JustavGunker/AMR-Project/34720 Fagprojekt Space1/stm32g431.jpg

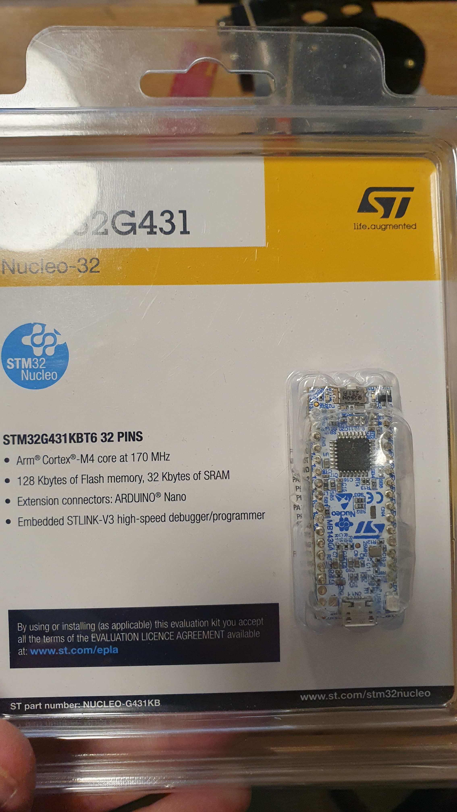
34720 Fagprojekt Space1/stm32g431.jpg
