JustavGunker/AMR-Project/34720 Fagprojekt Space1/block_diagram_inital.jpeg

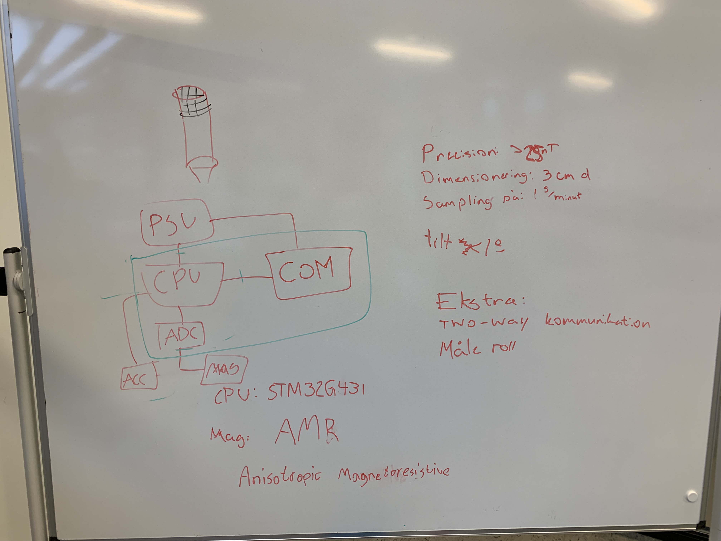
34720 Fagprojekt Space1/block_diagram_inital.jpeg
