JustavGunker/AMR-Project/README.md

# AMR-Project
Introductory Project in Electrotechnology 2024. AMR sensor system built with STM32G431
