JustavGunker/AMR-Project/34720 Fagprojekt Space1/block_diagram_final.jpg

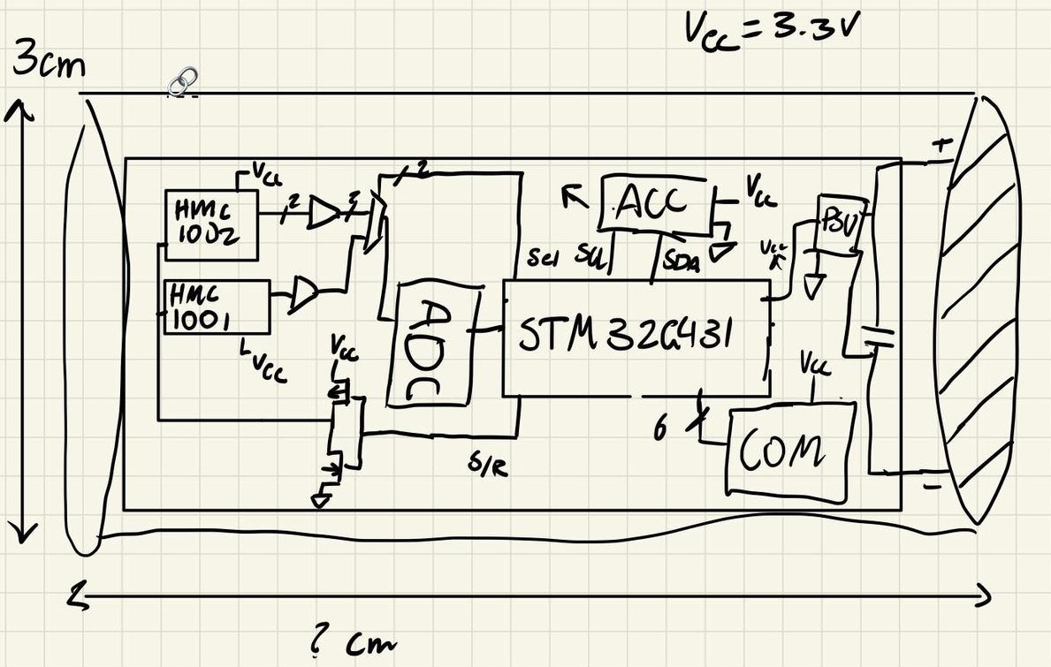
34720 Fagprojekt Space1/block_diagram_final.jpg
