JustavGunker/AMR-Project/34720 Fagprojekt Space1/schematic_amr.png

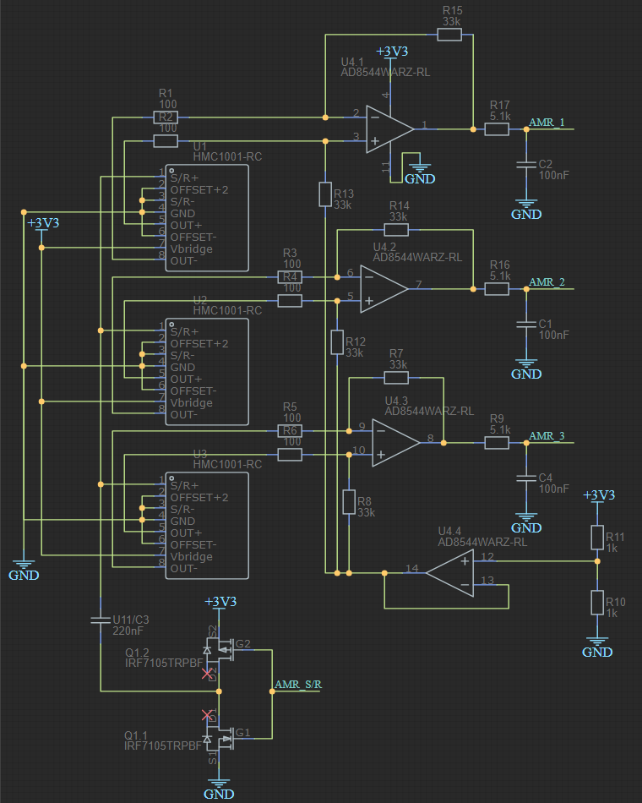
34720 Fagprojekt Space1/schematic_amr.png
