JustavGunker/AMR-Project/34720 Fagprojekt Space1/schematic_digital.png

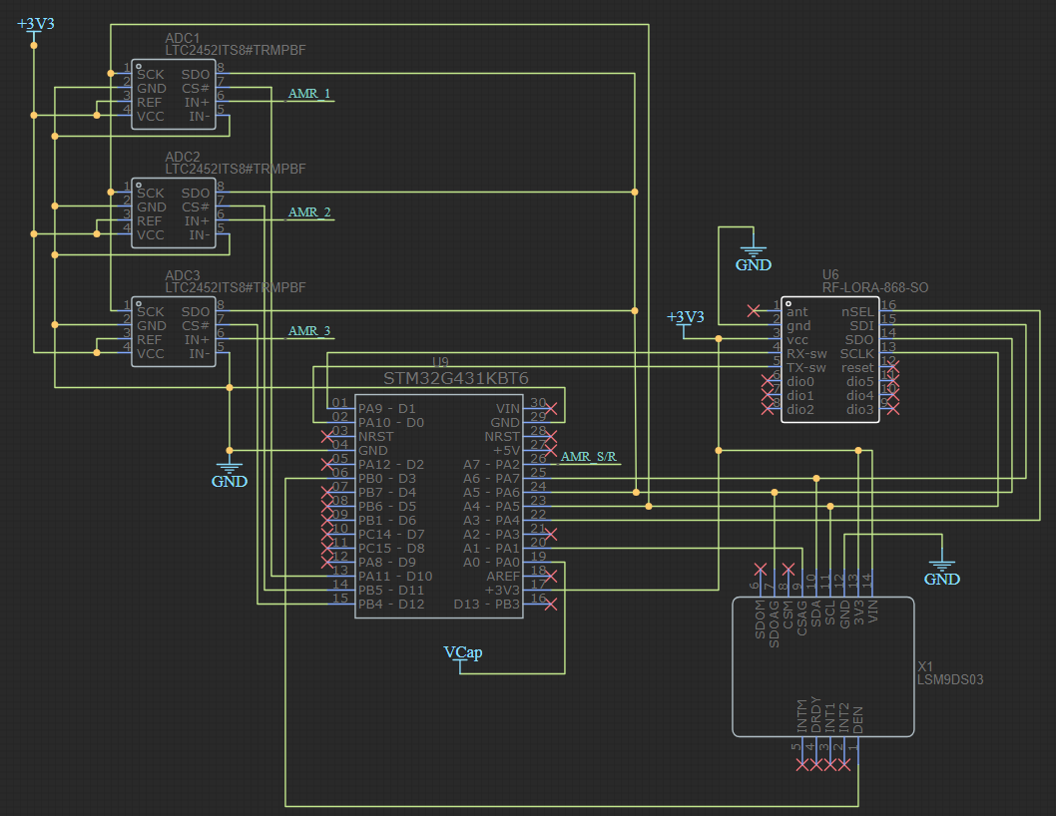
34720 Fagprojekt Space1/schematic_digital.png
