JustavGunker/AMR-Project/34720 Fagprojekt Space1/schematic_psu.png

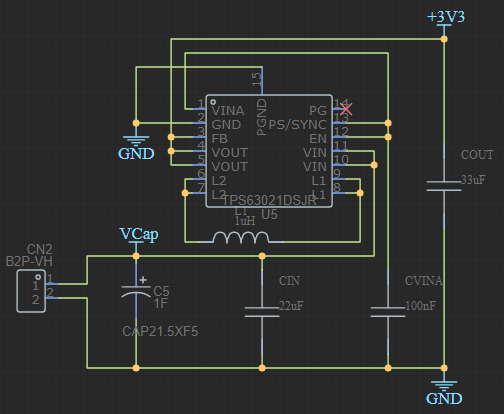
34720 Fagprojekt Space1/schematic_psu.png
