JustavGunker/AMR-Project/Receiver_CPU/receiver/Core/Src/main.c

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
/* Includes ------------------------------------------------------------------*/
#include "main.h"

/* USER CODE BEGIN Includes */
#include <stdio.h>
#include "tilt.h"
#include "adc.h"
#include "lora.h"


#include "string.h"
#include "stdio.h"
#include "lora.h"


/* USER CODE END Includes */

/* USER CODE BEGIN PTD */
adc_t adc1;
adc_t adc2;
adc_t adc3;
/* USER CODE END PTD */

SPI_HandleTypeDef hspi1;

/* USER CODE BEGIN PV */

<<<<<<<< HEAD:AMR_receiver/receiver/Core/Src/main.c
uint8_t hello[15] = "Hello, World!\n\r";
uint8_t new_line[1] = "\n";


char uart_buf[50];
uint8_t uart_buf_len;
int ESC = 0x1B;
uint8_t rx_buffer[256];

========
>>>>>>>> f46711b7818af0db365b4cb3413287fc9408f5cf:AMR-CPU/Core/Src/main.c

/* USER CODE END PV */

void SystemClock_Config(void);
static void MX_GPIO_Init(void);
static void MX_SPI1_Init(void);
/* USER CODE BEGIN PFP */
float read_battery(ADC_HandleTypeDef *hadc);
void transmit_data(SPI_HandleTypeDef* spi, char* data);
void get_measurements(SPI_HandleTypeDef* spi, adc_t adcx, adc_t adcy, adc_t adcz, char* data);
/* USER CODE END PFP */

/* USER CODE BEGIN 0 */

void clrscr();
void gotoxy(uint8_t x, uint8_t y);
void uart_read(void);
void enter_lpr_mode();
void exit_lpr_mode();

/* USER CODE END 0 */

/**
  * @brief  The application entry point.
  * @retval int
  */
int main(void)
{

  /* MCU Configuration--------------------------------------------------------*/

  /* Reset of all peripherals, Initializes the Flash interface and the Systick. */
  HAL_Init();

  /* Configure the system clock */
  SystemClock_Config();

  /* Initialize all configured peripherals */
  MX_GPIO_Init();
  MX_SPI1_Init();
  /* USER CODE BEGIN 2 */
<<<<<<<< HEAD:AMR_receiver/receiver/Core/Src/main.c
  char send_data[200];
  uint8_t rx, rx1, rx2, rx_flag, reg_value, send_it, cnt = 0;
  uint8_t tx, tx1 = 0;
  uint8_t addr, addr2, addr3 = 0;
  uint8_t mode;

  char data_read[100];

  uint8_t uart_buf_len = 0;

  HAL_GPIO_WritePin(GPIOA, RST_LoRa_Pin, GPIO_PIN_RESET);
  LoRa_reset();


  clrscr();
  gotoxy(0,0);

  LoRa_init(&hspi1);

  HAL_GPIO_WritePin(GPIOA, TX_Pin, GPIO_PIN_RESET);
  HAL_GPIO_WritePin(GPIOA, RX_Pin, GPIO_PIN_SET);

  LoRa_write_reg(&hspi1, RegFiFoTxBaseAddr, 0x00);
  HAL_Delay(10);

  //LoRa_fill_fifo(&hspi1, text, strlen(text));

  LoRa_set_mode(&hspi1, rx_cont_mode);
  mode = 1;
========
  HAL_PWREx_EnableLowPowerRunMode(); // enable low power run
  LSM9DS1_Init(&hspi1);
  ADC_Init(&adc1,&adc2,&adc3);
  //LoRa_reset();
  LoRa_init(&hspi1);

  HAL_GPIO_WritePin(GPIOA, TX_Pin, GPIO_PIN_SET);  // Enable TX path
  HAL_GPIO_WritePin(GPIOA, RX_Pin,GPIO_PIN_RESET); // Disable RX path

  char tx_data[100];
  float battery;
  uint8_t low_battery = 0;
  uint8_t first = 1; // To check for first measurement to bypass delay in first while loop

  // Initialize delay
  uint32_t tickstart = HAL_GetTick();
  uint32_t wait = 1500; // Time to wait between each measurement + transmission
  /* Add a freq to guarantee minimum wait */
  if (wait < HAL_MAX_DELAY){
  	  wait += (uint32_t)(uwTickFreq);
  	  }

>>>>>>>> f46711b7818af0db365b4cb3413287fc9408f5cf:AMR-CPU/Core/Src/main.c

  /* USER CODE END 2 */

  /* Infinite loop */
  /* USER CODE BEGIN WHILE */

  while (1)
  {
	  battery = read_battery(&hadc1);

	  if(battery < 1.0 && low_battery){
		  break;
	  }	else if(battery < 1.0){
		  low_battery = 1;
		  strcpy(tx_data, "");
		  sprintf(tx_data,"Battery low");
		  transmit_data(&hspi1, tx_data);
		  break;
	  } else if(!((HAL_GetTick() - tickstart) < wait) || first){
		  if(first){
			  first = 0;
			  HAL_Delay(1000);
		  }

		  low_battery = 0;
		  // Set reset of AMR-sensors
		  HAL_GPIO_WritePin(GPIOA, AMR_RESET_Pin,GPIO_PIN_SET);
		  HAL_GPIO_WritePin(GPIOA, AMR_RESET_Pin,GPIO_PIN_RESET);

		  // Sensor measurements, calculations and transmission of data
		  get_measurements(&hspi1,adc3,adc2,adc1,tx_data);
		  transmit_data(&hspi1, tx_data);

		  // Restart delay
		  tickstart = HAL_GetTick();
		  wait = 1500;
		  if (wait < HAL_MAX_DELAY){
			  wait += (uint32_t)(uwTickFreq);
			  }
	  }

    /* USER CODE END WHILE */

    /* USER CODE BEGIN 3 */
	  gotoxy(0,0);

	  /*
	  //LoRa receive and print and send for 2-way com
	  if (mode != 1) {
		  toggle_pins(&hspi1);
		  LoRa_set_mode(&hspi1, rx_cont_mode);
		  mode = 1;
		  rx = 0;
		  clrscr();
	  }

	  rx = (LoRa_read_reg(&hspi1, RegIrqFlags) & 0x40) >> 6;

	  LoRa_read_payload(&hspi1, data_read);

	  rx1 = LoRa_read_reg(&hspi1, RegRxNbBytes);
	  rx2 = LoRa_read_reg(&hspi1, RegOpMode);

	  uart_buf_len = sprintf(send_data, "Waiting, RegOpMode: %d, mode: %d\n\r", rx2, mode);
	  HAL_UART_Transmit(&huart2, (uint8_t*)send_data, uart_buf_len, 500);

	  if (rx) {
		  uart_buf_len = sprintf(send_data, "Payload: %s, rx_done: %d, bytes: %d", data_read,  rx, rx1);
		  HAL_UART_Transmit(&huart2, (uint8_t*)send_data, uart_buf_len, 500);
		  HAL_Delay(5000);
		  clrscr();

		  for (int i = 0; i <= 2; i++) {
			  LoRa_fill_fifo(&hspi1, text, strlen(text));
			  toggle_pins(&hspi1);
			  LoRa_set_mode(&hspi1, tx_mode);
			  mode = 0;
			  reg_value = LoRa_read_reg(&hspi1, RegOpMode);
			  tx = (LoRa_read_reg(&hspi1, RegIrqFlags) & 0x08) >> 3;
			  if (tx) {
				  send_it = 1;
				  LoRa_write_reg(&hspi1, RegIrqFlags, 0x08);
				  tx = 0;
				  sprintf(send_data, "send it: %d, mode: %d", send_it, reg_value);
				  HAL_UART_Transmit(&huart2, (uint8_t*)send_data, strlen(send_data), 500);
				  send_it = 0;
			  }

			  HAL_Delay(1000);
		  }
		  LoRa_set_mode(&hspi1, sleep_mode);
		  mode = 0;
		  HAL_Delay(10);
	  }*/


	  //LoRa receive and print
	  rx = (LoRa_read_reg(&hspi1, RegIrqFlags) & 0x40) >> 6;

	  rx1 = LoRa_read_reg(&hspi1, RegRxNbBytes);
	  rx2 = LoRa_read_reg(&hspi1, RegOpMode);

	  uart_buf_len = sprintf(send_data, "Waiting, RegOpMode: %d\n\r", rx2);
	  HAL_UART_Transmit(&huart2, (uint8_t*)send_data, uart_buf_len, 500);

	  if (rx) {
		  LoRa_read_payload(&hspi1, data_read);
		  clrscr();
		  uart_buf_len = sprintf(send_data, "Payload:\n\r%s\n\rbytes: %d", data_read, rx1);
		  HAL_UART_Transmit(&huart2, (uint8_t*)send_data, uart_buf_len, 500);
		  LoRa_set_mode(&hspi1, sleep_mode);
		  HAL_Delay(10);
		  LoRa_set_mode(&hspi1, rx_cont_mode);
	  }



  }
  /* USER CODE END 3 */
}

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
/* USER CODE BEGIN 4 */
float read_battery(ADC_HandleTypeDef *hadc){
	uint16_t adc_read;
	HAL_ADC_Start(hadc);
	HAL_ADC_PollForConversion(hadc,HAL_MAX_DELAY);
	adc_read = HAL_ADC_GetValue(hadc);

	return (float)(adc_read*3.3)/4096;
}

void transmit_data(SPI_HandleTypeDef* spi, char* data){
	  uint8_t addr = RegIrqFlags;
	  LoRa_set_mode(spi,stdby_mode);
	  HAL_Delay(10);

	  LoRa_fill_fifo(spi, data, strlen(data));
	  LoRa_set_mode(spi, tx_mode);
	  HAL_Delay(10);
	  if(LoRa_read_reg(spi, addr) & 0x08){
		  LoRa_write_reg(spi,addr,0x08);
		  HAL_Delay(10);
	  }
	  HAL_Delay(10);
	  LoRa_set_mode(spi,sleep_mode);
	  HAL_Delay(10);
}

void get_measurements(SPI_HandleTypeDef* spi, adc_t adcx, adc_t adcy, adc_t adcz, char* data){
	  double tilt = 0;
	  float magx, magy, magz = 0.0;
	  float vol1, vol2, vol3;
	  uint16_t adcval1, adcval2, adcval3;

	  tilt = get_tilt(spi);

	  magx = get_magx(spi, adcx);
	  magy = get_magy(spi,adcy);
	  magz = get_magz(spi,adcz);

	  adcval1 = LTC2452_Read(spi, adcx);
	  adcval2 = LTC2452_Read(spi, adcy);
	  adcval3 = LTC2452_Read(spi, adcz);

	  vol1 = convVol(adcval1,3.3);
	  vol2 = convVol2(adcval2,3.3);
	  vol3 = convVol2(adcval3,3.3);

	  sprintf(data,"Volx: %4.3f\n\rX: %4.3f %cT\n\rVoly: %4.3f\n\rY: %4.3f %cT\n\rVolz: %4.3f\n\rZ: %4.3f %cT\n\rTilt: %4.2f%c",vol1,magx,0xE6,vol2, magy,0xE6, vol3,magz,0xE6,tilt, 0xA7);
}

void clrscr() {
	uart_buf_len = sprintf(uart_buf, "%c[2J", ESC);
	HAL_UART_Transmit(&huart2, (uint8_t *)uart_buf, uart_buf_len, 100);
}

void gotoxy(uint8_t x, uint8_t y) {
	uart_buf_len = sprintf(uart_buf, "%c[%d;%dH", ESC, y + 1, x + 1);
	HAL_UART_Transmit(&huart2, (uint8_t *)uart_buf, uart_buf_len, 100);
}

void uart_read(void) {
	uint8_t rx_data;
	uint8_t index = 0;
	while (1) {
		if (HAL_UART_Receive(&huart2, &rx_data, 1, HAL_MAX_DELAY) == HAL_OK) {
			if (rx_data == '\r') {
				rx_buffer[index] = '\0';
				index = 0;
				break;
			}
			else if (index < 256 - 1) {
				rx_buffer[index++] = rx_data;
			}
		}
	}
}

void enter_lpr_mode() {
	PWR -> CR1 |= 0x4000;
}

void exit_lpr_mode() {
	uint8_t x;
	PWR -> CR1 |= ~(0x4000);
	while (1) {
		x = (PWR -> SR2 & 0x200) >> 9;
		if (!x) {
			break;
		}
	}
}

/* USER CODE END 4 */
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
