JustavGunker/AMR-Project/Receiver_CPU/receiver/Core/Inc/main.h

#define CS_LoRa_Pin GPIO_PIN_4
#define CS_LoRa_GPIO_Port GPIOA
#define TX_Pin GPIO_PIN_8
#define TX_GPIO_Port GPIOA
#define RST_LoRa_Pin GPIO_PIN_9
#define RST_LoRa_GPIO_Port GPIOA
#define DIO0_Pin GPIO_PIN_10
#define DIO0_GPIO_Port GPIOA
#define RX_Pin GPIO_PIN_12
#define RX_GPIO_Port GPIOA
#define CSAG_Pin GPIO_PIN_1
#define CSAG_GPIO_Port GPIOA
#define AMR_RESET_Pin GPIO_PIN_2
#define AMR_RESET_GPIO_Port GPIOA
#define CS_LoRa_Pin GPIO_PIN_4
#define CS_LoRa_GPIO_Port GPIOA
#define DEN_Pin GPIO_PIN_0
#define DEN_GPIO_Port GPIOB
#define RST_LoRa_Pin GPIO_PIN_8
#define RST_LoRa_GPIO_Port GPIOA
#define RX_Pin GPIO_PIN_9
#define RX_GPIO_Port GPIOA
#define TX_Pin GPIO_PIN_10
#define TX_GPIO_Port GPIOA
#define CSADC1_Pin GPIO_PIN_11
#define CSADC1_GPIO_Port GPIOA
#define CSADC3_Pin GPIO_PIN_4
#define CSADC3_GPIO_Port GPIOB
#define CSADC2_Pin GPIO_PIN_5
#define CSADC2_GPIO_Port GPIOB
