JustavGunker/AMR-Project/(commit log)

2024-06-10 ADC and Tilt reading
2024-06-11 Power files
2024-06-21 Magnet translation and calibration
2024-06-25 Receiver debug drivers
2024-06-25 Battery threshold
